ruanjiacheng/wheel_legged_robot/foc-wheel-legged-robot-master/android/readme-img/config.png

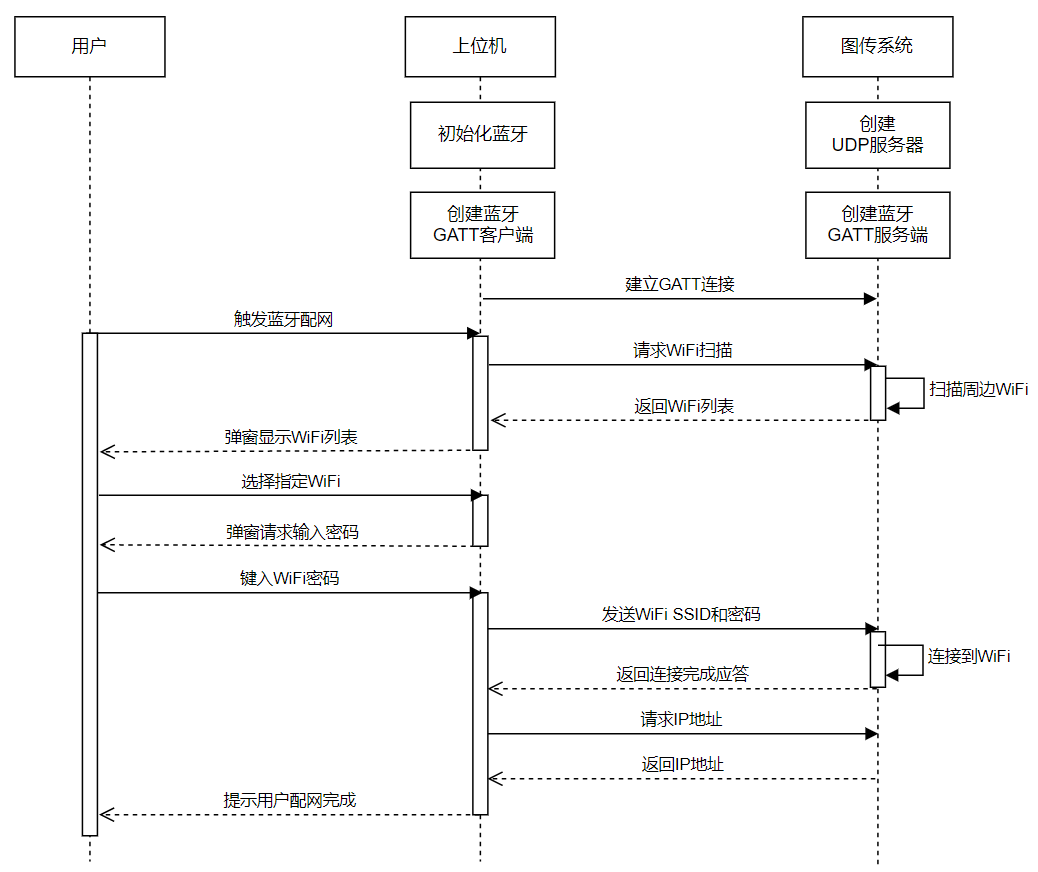
foc-wheel-legged-robot-master/android/readme-img/config.png
