ruanjiacheng/wheel_legged_robot/foc-wheel-legged-robot-master/android/readme-img/connect.png

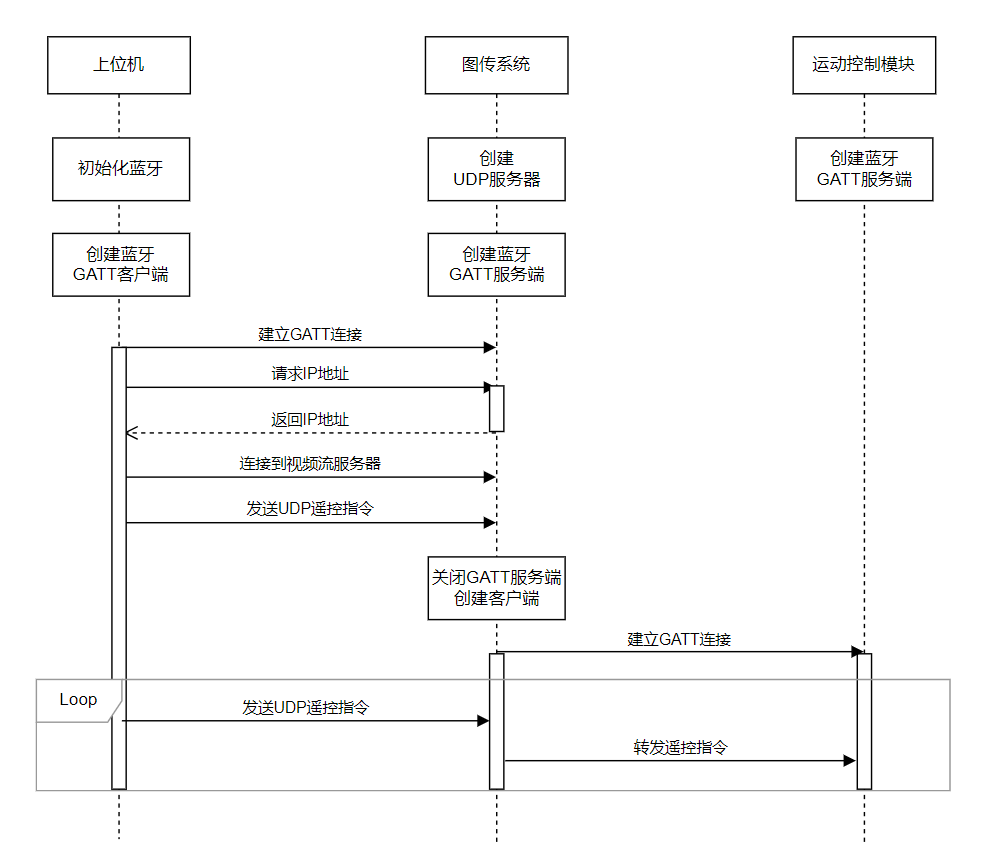
foc-wheel-legged-robot-master/android/readme-img/connect.png
