ruanjiacheng/wheel_legged_robot/foc-wheel-legged-robot-master/esp32-controller/readme-img/design.png

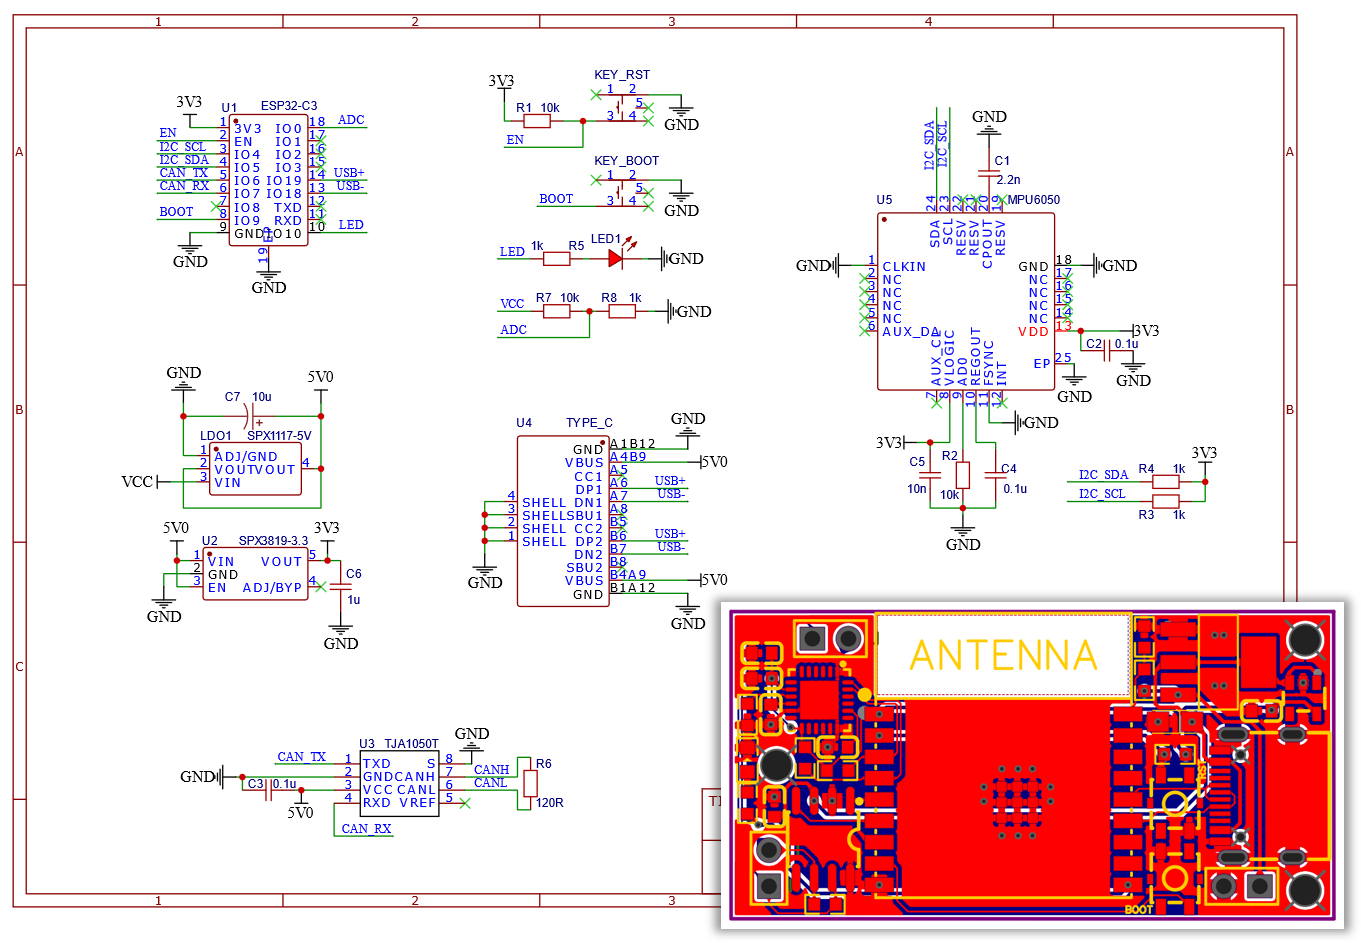
foc-wheel-legged-robot-master/esp32-controller/readme-img/design.png
