ruanjiacheng/wheel_legged_robot/foc-wheel-legged-robot-master/linux-fpv/readme-img/connect.png

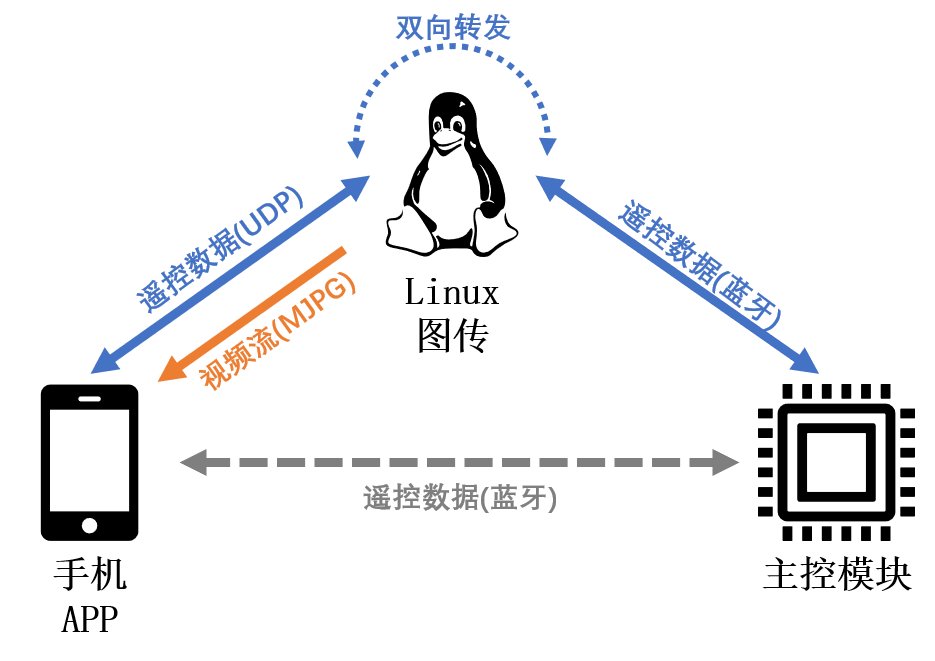
foc-wheel-legged-robot-master/linux-fpv/readme-img/connect.png
