ruanjiacheng/wheel_legged_robot/foc-wheel-legged-robot-master/linux-fpv/readme-img/nanopi.png

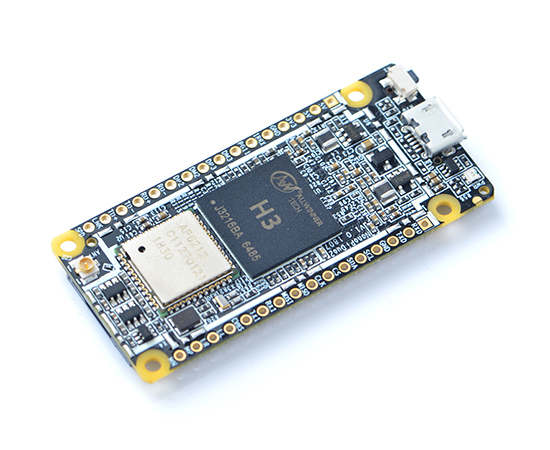
foc-wheel-legged-robot-master/linux-fpv/readme-img/nanopi.png
