ruanjiacheng/wheel_legged_robot/foc-wheel-legged-robot-master/solidworks/readme-img/2804.png

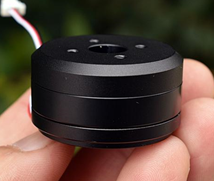
foc-wheel-legged-robot-master/solidworks/readme-img/2804.png
