ruanjiacheng/wheel_legged_robot/foc-wheel-legged-robot-master/solidworks/readme-img/explode.jpg

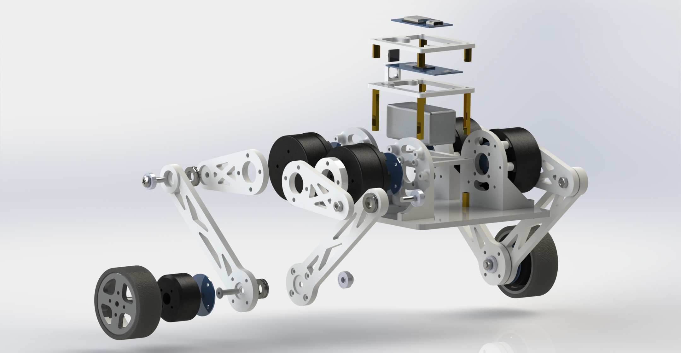
foc-wheel-legged-robot-master/solidworks/readme-img/explode.jpg
