ruanjiacheng/wheel_legged_robot/foc-wheel-legged-robot-master/solidworks/readme-img/tire.png

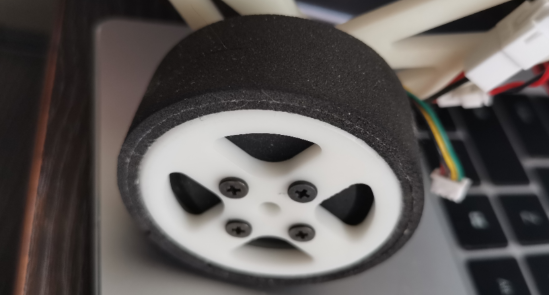
foc-wheel-legged-robot-master/solidworks/readme-img/tire.png
