ruanjiacheng/wheel_legged_robot/foc-wheel-legged-robot-master/stm32-foc/readme-img/design.png

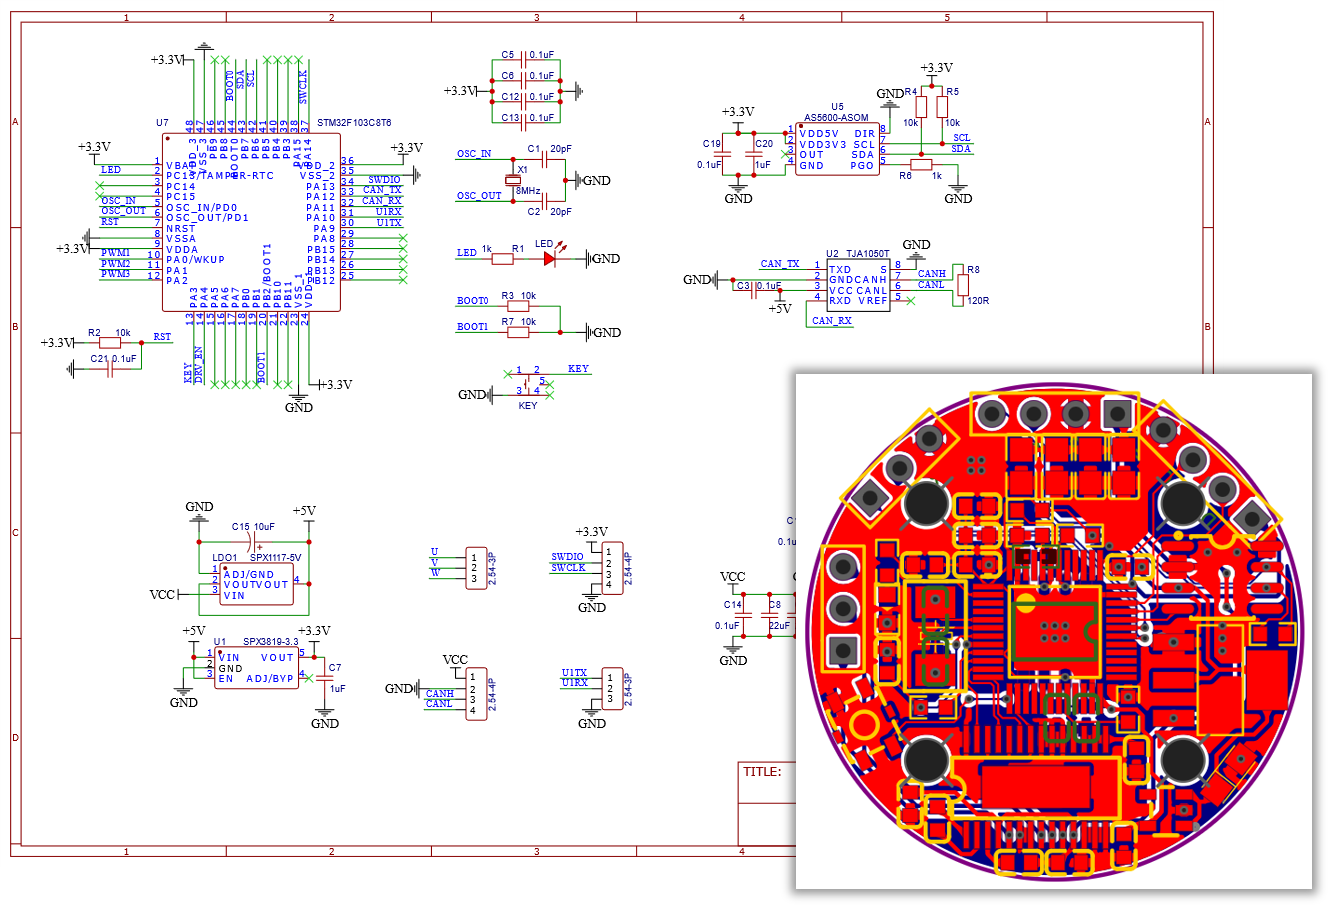
foc-wheel-legged-robot-master/stm32-foc/readme-img/design.png
