ruanjiacheng/wheel_legged_robot/foc-wheel-legged-robot-master/solidworks/总装.SLDASM

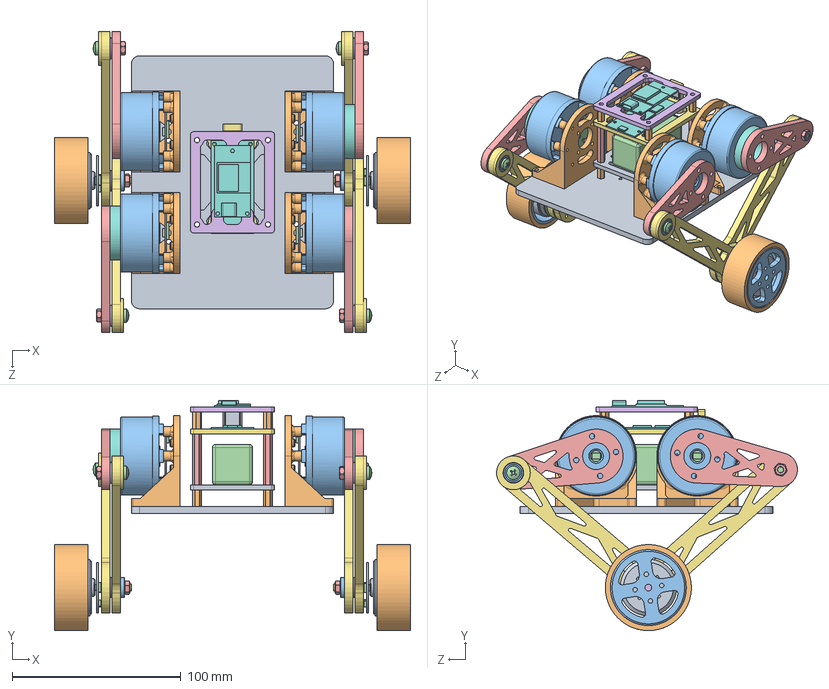
[picture p19: CAD file, 2025-01-12]
foc-wheel-legged-robot-master/solidworks/总装.SLDASM
211.0 x 136.4 x 178.3 mm
底板
关节电机支架 x 4
4010电机 x 4
驱动板 x 6
大腿 x 4
推力轴承 x 6
小腿 x 4
大腿垫高 x 2
2804电机 x 2
轮胎 x 2
MISUMI_C-SE604ZZ_不锈钢小径滚珠轴承 x 6
cross recessed pan head screws gb x 4
hex nuts, style 1-grades ab gb x 6
编码器磁铁 x 2
MISUMI_CBSTSR4-16_内六角螺栓（盖螺栓） x 2
主控板PCB
电池架
电池支撑铜柱 x 8
车轮 x 2
动力锂电池
主控支撑铜柱 x 4
主控支架
NanoPi支架
NanoPi
OV5640镜头
