ruanjiacheng/wheel_legged_robot/foc-wheel-legged-robot-master/solidworks/推力轴承.SLDPRT

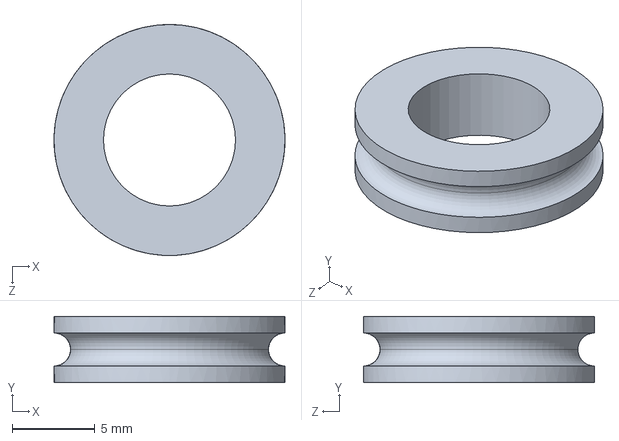
[picture p20: CAD file, 2025-01-12]
foc-wheel-legged-robot-master/solidworks/推力轴承.SLDPRT
14.0 x 4.00 x 14.0 mm
