ruanjiacheng/wheel_legged_robot/foc-wheel-legged-robot-master/solidworks/主控支撑铜柱.SLDPRT

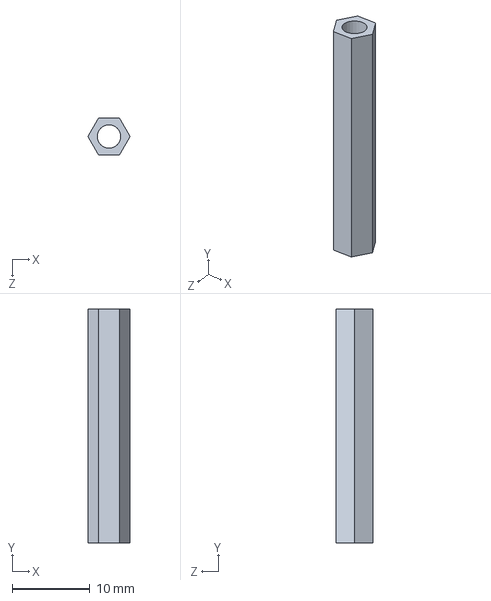
[picture p21: CAD file, 2025-01-12]
foc-wheel-legged-robot-master/solidworks/主控支撑铜柱.SLDPRT
5.43 x 30.0 x 4.70 mm
