ruanjiacheng/wheel_legged_robot/foc-wheel-legged-robot-master/solidworks/NanoPi.SLDPRT

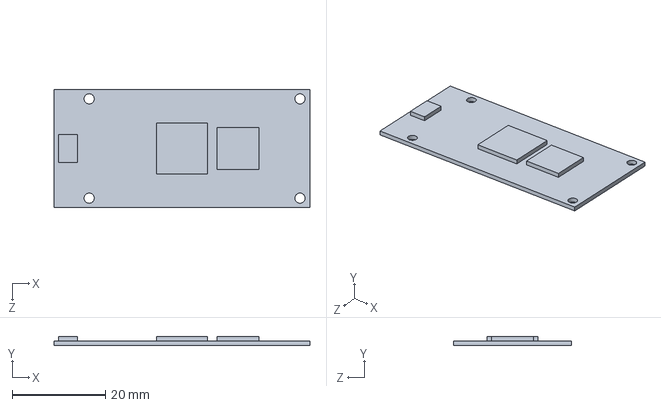
[picture p22: CAD file, 2025-01-12]
foc-wheel-legged-robot-master/solidworks/NanoPi.SLDPRT
55.0 x 2.00 x 25.4 mm
