ruanjiacheng/wheel_legged_robot/foc-wheel-legged-robot-master/solidworks/主控支架.SLDPRT

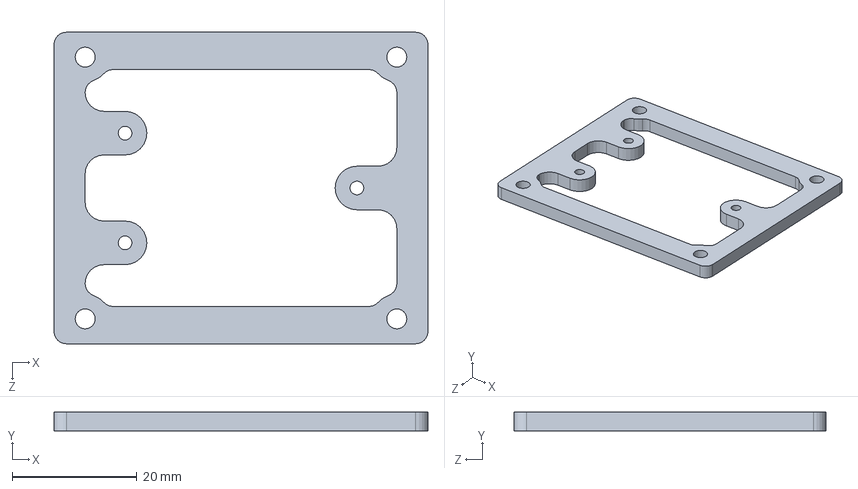
[picture p23: CAD file, 2025-01-12]
foc-wheel-legged-robot-master/solidworks/主控支架.SLDPRT
60.0 x 3.00 x 50.0 mm
