ruanjiacheng/wheel_legged_robot/foc-wheel-legged-robot-master/solidworks/编码器磁铁.SLDPRT

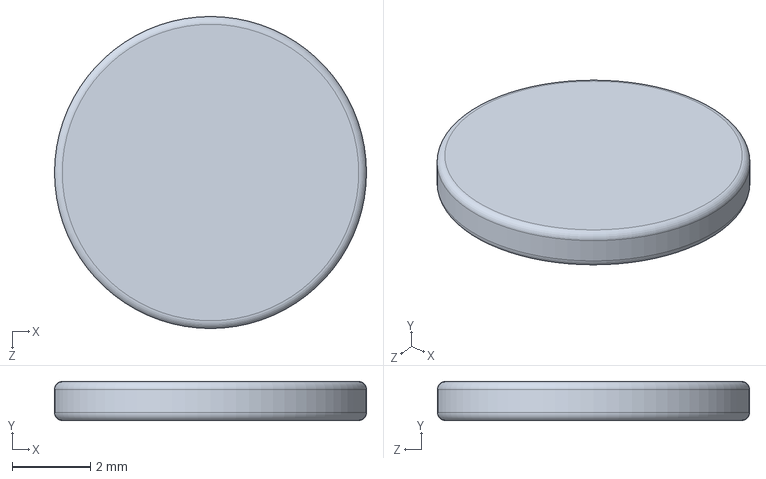
[picture p24: CAD file, 2025-01-12]
foc-wheel-legged-robot-master/solidworks/编码器磁铁.SLDPRT
8.00 x 1.00 x 8.00 mm
