ruanjiacheng/wheel_legged_robot/foc-wheel-legged-robot-master/solidworks/大腿垫高.SLDPRT

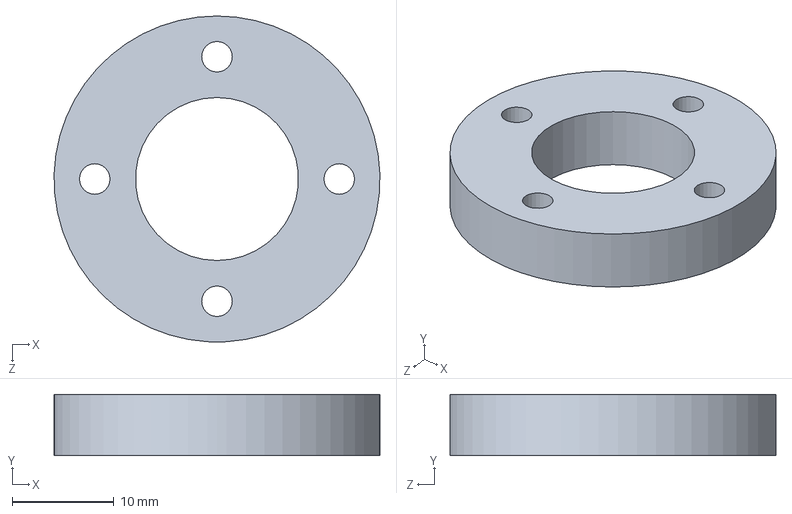
[picture p25: CAD file, 2025-01-12]
foc-wheel-legged-robot-master/solidworks/大腿垫高.SLDPRT
32.0 x 6.00 x 32.0 mm
