ruanjiacheng/wheel_legged_robot/foc-wheel-legged-robot-master/solidworks/小腿.SLDPRT

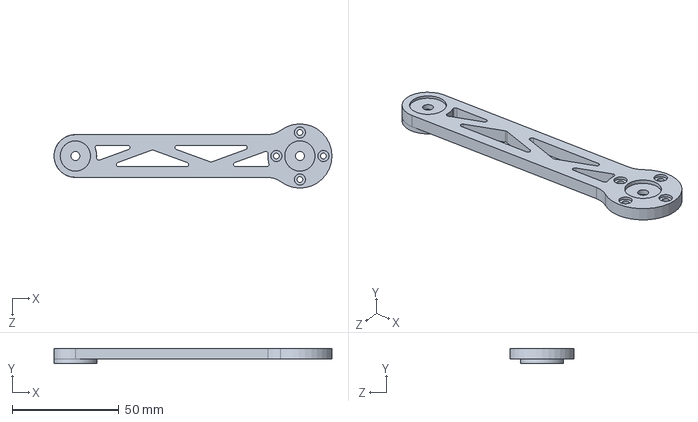
[picture p26: CAD file, 2025-01-12]
foc-wheel-legged-robot-master/solidworks/小腿.SLDPRT
130.0 x 7.00 x 30.0 mm
