ruanjiacheng/wheel_legged_robot/foc-wheel-legged-robot-master/solidworks/2804电机.SLDPRT

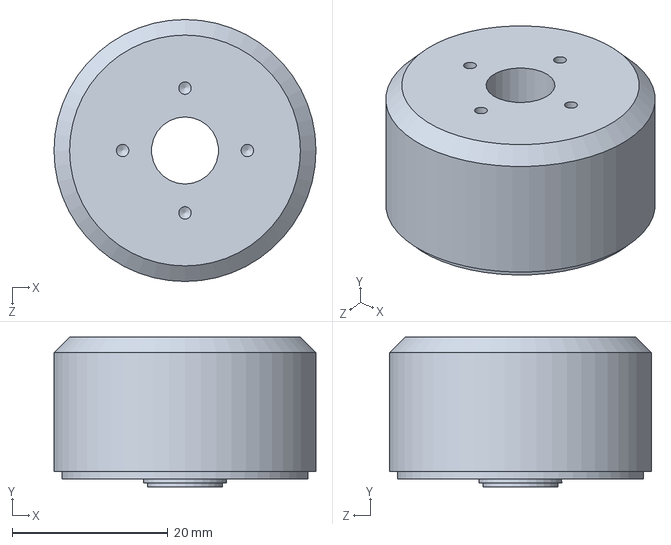
[picture p27: CAD file, 2025-01-12]
foc-wheel-legged-robot-master/solidworks/2804电机.SLDPRT
33.6 x 19.2 x 33.6 mm
