ruanjiacheng/wheel_legged_robot/foc-wheel-legged-robot-master/solidworks/4010电机.SLDPRT

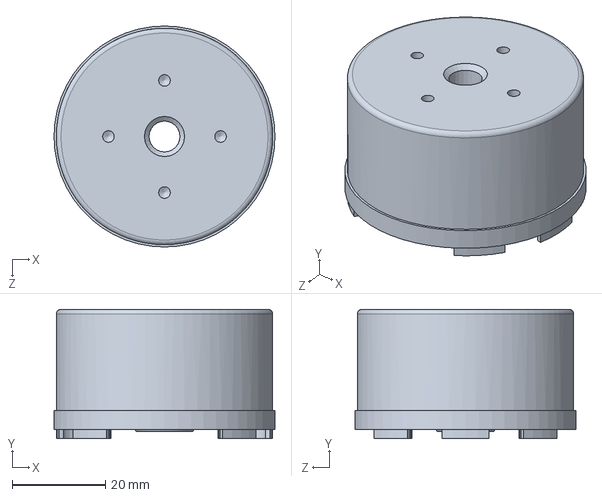
[picture p28: CAD file, 2025-01-12]
foc-wheel-legged-robot-master/solidworks/4010电机.SLDPRT
47.3 x 27.7 x 47.3 mm
