ruanjiacheng/wheel_legged_robot/foc-wheel-legged-robot-master/solidworks/大腿.SLDPRT

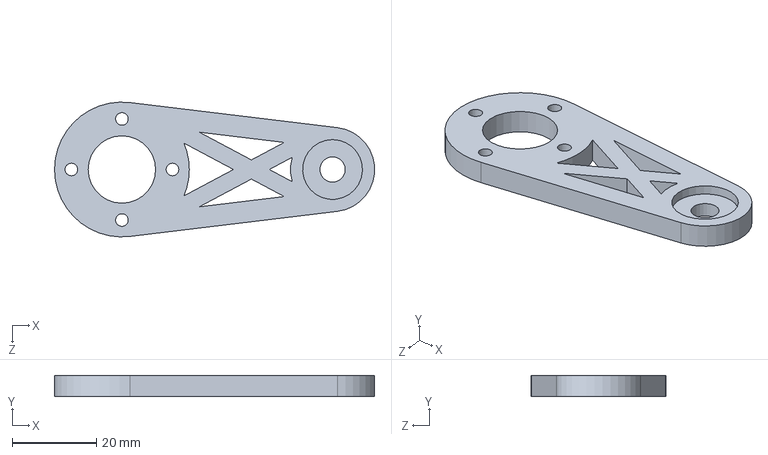
[picture p29: CAD file, 2025-01-12]
foc-wheel-legged-robot-master/solidworks/大腿.SLDPRT
76.0 x 5.00 x 32.0 mm
