ruanjiacheng/wheel_legged_robot/foc-wheel-legged-robot-master/solidworks/驱动板.SLDPRT

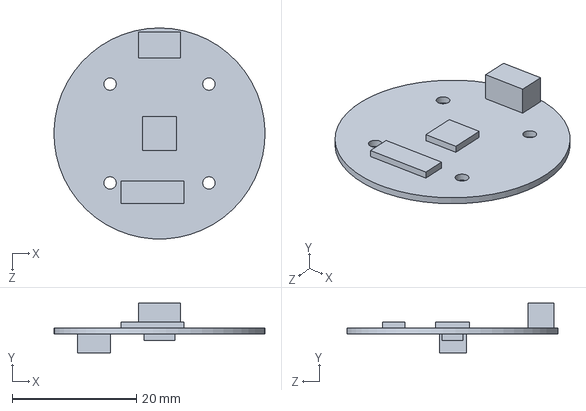
[picture p30: CAD file, 2025-01-12]
foc-wheel-legged-robot-master/solidworks/驱动板.SLDPRT
34.0 x 8.00 x 34.0 mm
