ruanjiacheng/wheel_legged_robot/foc-wheel-legged-robot-master/solidworks/轮胎.SLDPRT

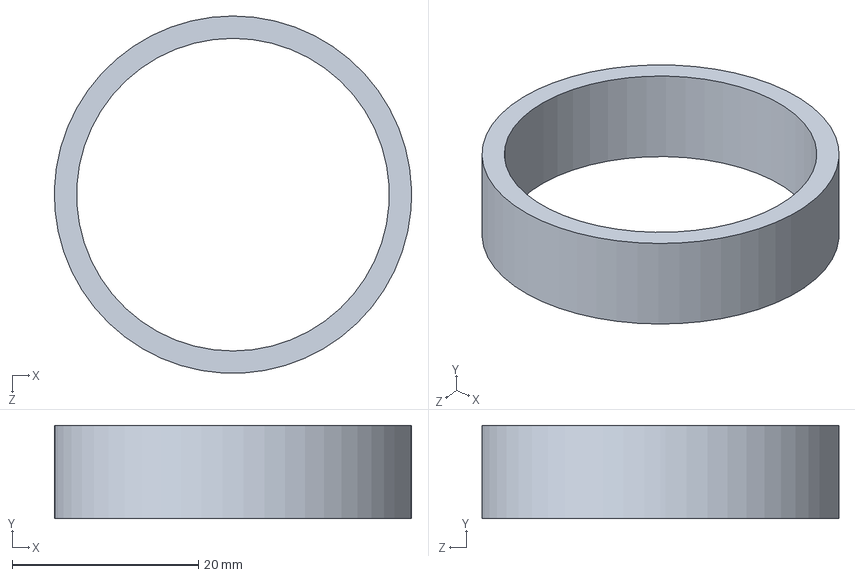
[picture p31: CAD file, 2025-01-12]
foc-wheel-legged-robot-master/solidworks/轮胎.SLDPRT
38.4 x 10.0 x 38.4 mm
