ruanjiacheng/wheel_legged_robot/foc-wheel-legged-robot-master/solidworks/关节电机支架.SLDPRT

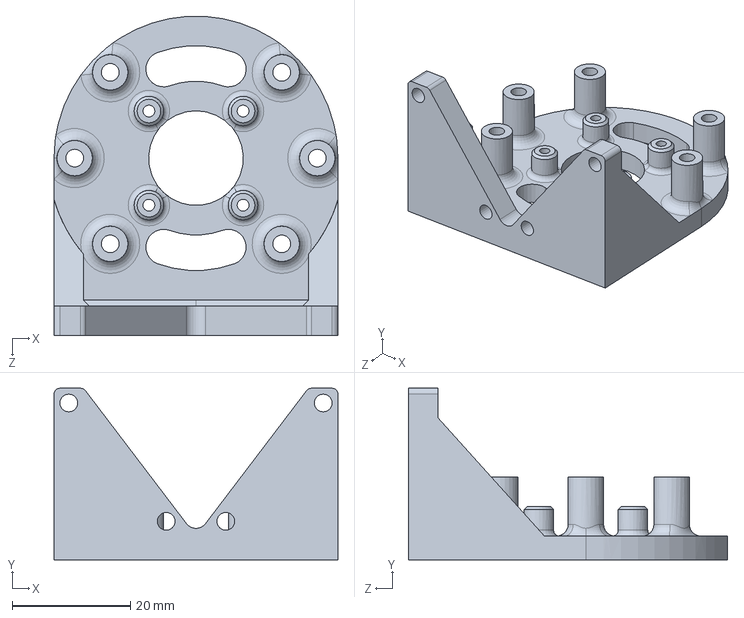
[picture p32: CAD file, 2025-01-12]
foc-wheel-legged-robot-master/solidworks/关节电机支架.SLDPRT
48.0 x 29.0 x 54.0 mm
