ruanjiacheng/wheel_legged_robot/foc-wheel-legged-robot-master/solidworks/NanoPi支架.SLDPRT

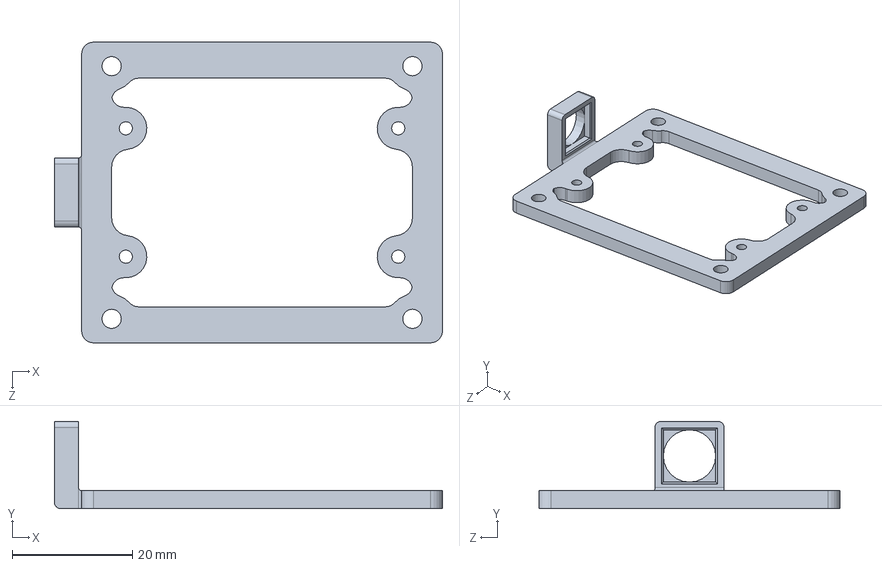
[picture p33: CAD file, 2025-01-12]
foc-wheel-legged-robot-master/solidworks/NanoPi支架.SLDPRT
64.5 x 14.5 x 50.0 mm
