ruanjiacheng/wheel_legged_robot/foc-wheel-legged-robot-master/solidworks/电池架.SLDPRT

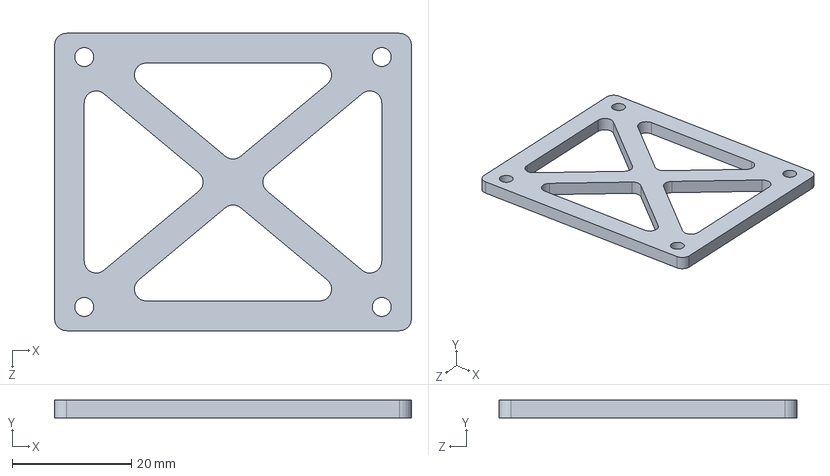
[picture p34: CAD file, 2025-01-12]
foc-wheel-legged-robot-master/solidworks/电池架.SLDPRT
60.0 x 3.00 x 50.0 mm
