ruanjiacheng/wheel_legged_robot/foc-wheel-legged-robot-master/solidworks/底板.SLDPRT

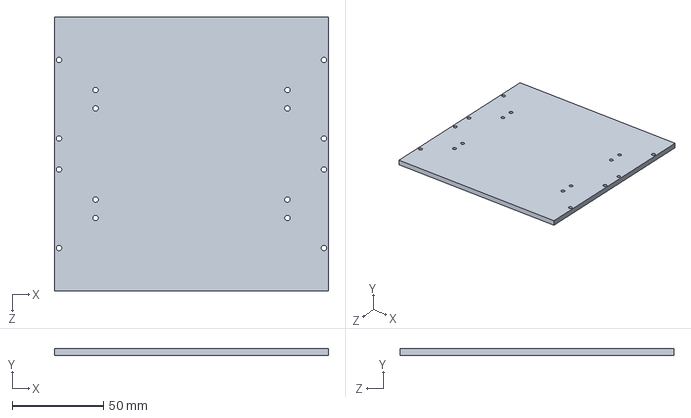
[picture p35: CAD file, 2025-01-12]
foc-wheel-legged-robot-master/solidworks/底板.SLDPRT
150.0 x 4.00 x 150.0 mm
