ruanjiacheng/wheel_legged_robot/foc-wheel-legged-robot-master/solidworks/hex nuts, style 1-grades ab gb.sldprt

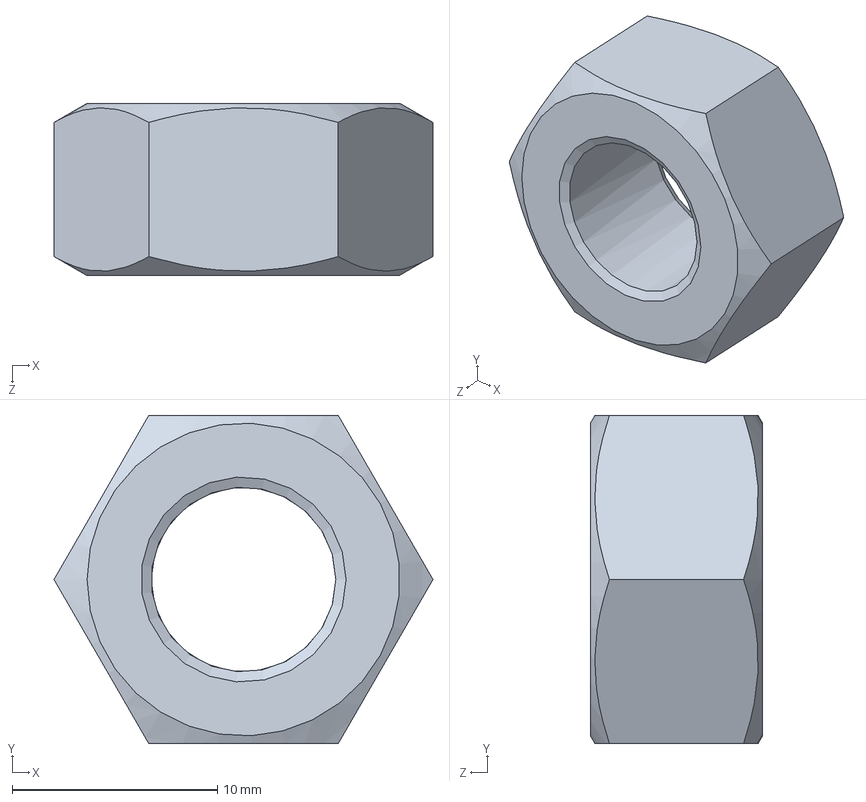
[picture p36: CAD file, 2025-01-12]
foc-wheel-legged-robot-master/solidworks/hex nuts, style 1-grades ab gb.sldprt
18.5 x 16.0 x 8.40 mm
