ruanjiacheng/wheel_legged_robot/foc-wheel-legged-robot-master/solidworks/动力锂电池.SLDPRT

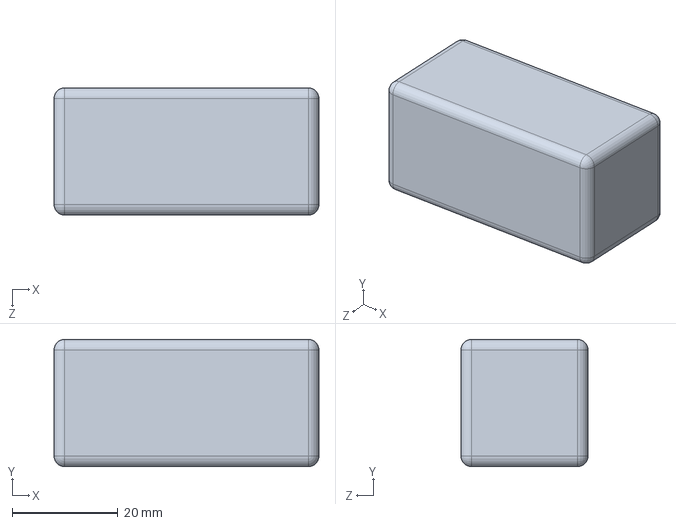
[picture p37: CAD file, 2025-01-12]
foc-wheel-legged-robot-master/solidworks/动力锂电池.SLDPRT
50.0 x 24.0 x 24.0 mm
