ruanjiacheng/wheel_legged_robot/foc-wheel-legged-robot-master/solidworks/车轮.SLDPRT

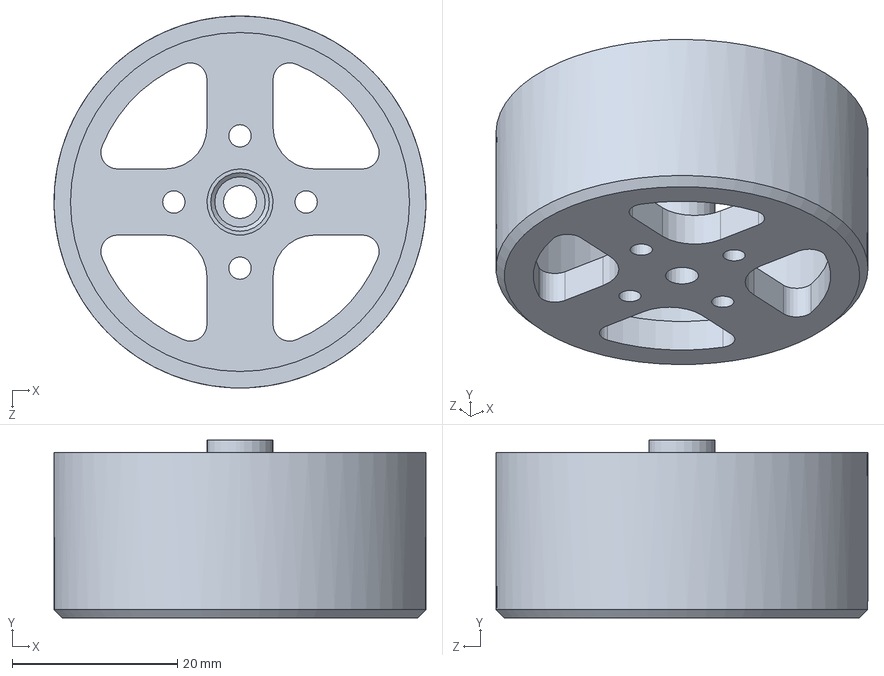
[picture p38: CAD file, 2025-01-12]
foc-wheel-legged-robot-master/solidworks/车轮.SLDPRT
45.0 x 21.5 x 45.0 mm
