ruanjiacheng/wheel_legged_robot/foc-wheel-legged-robot-master/solidworks/OV5640镜头.SLDPRT

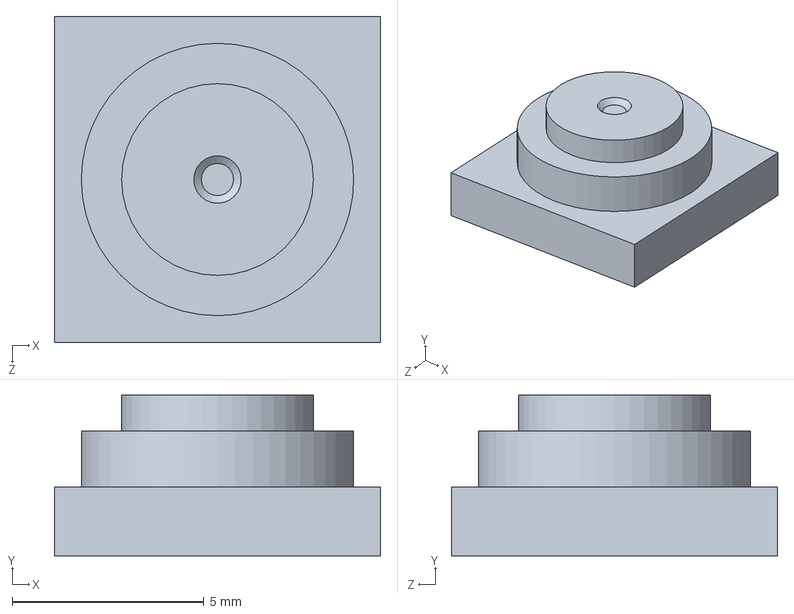
[picture p40: CAD file, 2025-01-12]
foc-wheel-legged-robot-master/solidworks/OV5640镜头.SLDPRT
8.50 x 4.19 x 8.50 mm
