ruanjiacheng/wheel_legged_robot/foc-wheel-legged-robot-master/solidworks/主控板PCB.SLDPRT

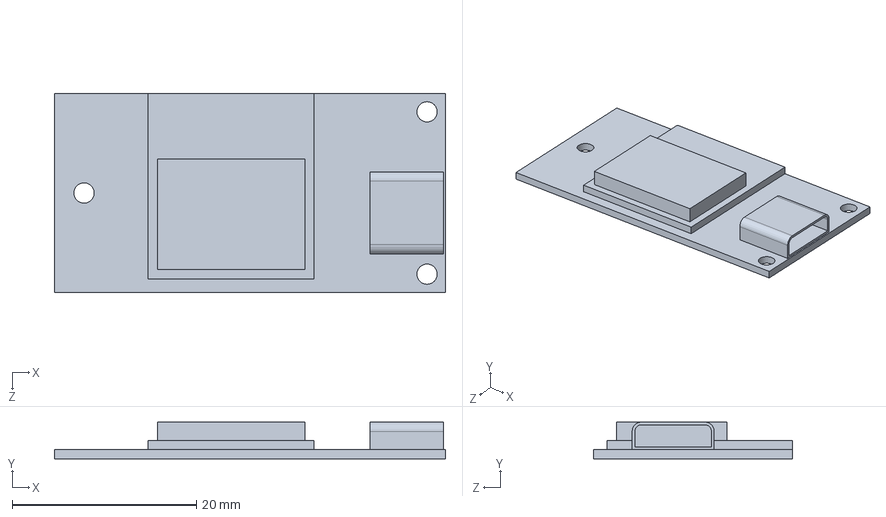
[picture p41: CAD file, 2025-01-12]
foc-wheel-legged-robot-master/solidworks/主控板PCB.SLDPRT
42.4 x 4.00 x 21.6 mm
