ruanjiacheng/wheel_legged_robot/(list of files, cad)

Other CAD files:
foc-wheel-legged-robot-master/solidworks/MISUMI_C-SE604ZZ_不锈钢小径滚珠轴承.SLDPRT
foc-wheel-legged-robot-master/solidworks/MISUMI_CBSTSR4-16_内六角螺栓（盖螺栓）.SLDPRT
foc-wheel-legged-robot-master/solidworks/cross recessed pan head screws gb.sldprt
