ruanjiacheng/wheel_legged_robot/(list of files, drawings)

Other design files:
foc-wheel-legged-robot-master/esp32-controller/hardware/ESP32CTRL_AD_PCB.pcbdoc
foc-wheel-legged-robot-master/esp32-controller/hardware/ESP32CTRL_AD_SCH.schdoc
foc-wheel-legged-robot-master/stm32-foc/hardware/STM32FOC_AD_PCB.pcbdoc
foc-wheel-legged-robot-master/stm32-foc/hardware/STM32FOC_AD_SCH.schdoc
