ruanjiacheng/wheel_legged_robot/foc-wheel-legged-robot-master/esp32-controller/software/src/leg_conv.h

/*
 * File: leg_conv.h
 *
 * MATLAB Coder version            : 5.5
 * C/C++ source code generated on  : 27-Jan-2023 14:46:28
 */

#ifndef LEG_CONV_H
#define LEG_CONV_H

/* Include Files */
#include <stdint.h>
#include <stddef.h>
#include <stdlib.h>

#ifdef __cplusplus
extern "C" {
#endif

/* Function Declarations */
extern void leg_conv(float F, float Tp, float phi1, float phi4, float T[2]);

#ifdef __cplusplus
}
#endif

#endif
/*
 * File trailer for leg_conv.h
 *
 * [EOF]
 */
