ruanjiacheng/wheel_legged_robot/foc-wheel-legged-robot-master/esp32-controller/software/src/lqr_k.h

/*
 * File: lqr_k.h
 *
 * MATLAB Coder version            : 5.5
 * C/C++ source code generated on  : 27-Jan-2023 15:11:40
 */

#ifndef LQR_K_H
#define LQR_K_H

/* Include Files */
#include <stdint.h>
#include <stddef.h>
#include <stdlib.h>

#ifdef __cplusplus
extern "C" {
#endif

/* Function Declarations */
extern void lqr_k(float L0, float K[12]);

#ifdef __cplusplus
}
#endif

#endif
/*
 * File trailer for lqr_k.h
 *
 * [EOF]
 */
